baoshi/KiCad/(commit log)

2016-10-09 Ai-Thinker ESP-3212 has been replaced with ESP-32S. Add new ESP-32S library, footprint and 3D design. Do not use ESP-3212. It will be removed soon.
2016-10-09 Blue PCB on ESP-32S module
2019-12-28 Updated to KiCad 5 with FreeCad 3D projects
2020-03-02 Added ESP32-WROOM-32X modules. Added USB Type A connector (HRO_U-A-24DS-Y-1) Added LM320Y OLED panel
2020-03-07 Added some TI chips. Slight footprint naming unification.
2020-03-08 Added ADS1115. Modified some VSSPOP footprint.
2020-03-08 Add 2 pin connector. Add TVS diodes.
2020-03-08 Add some diodes and capacitor
2020-03-15 Added 3.5mm screw terminal
2020-03-17 Test Points, Tactile buttons
2020-03-20 Push button 6x6mm
2020-03-23 INA226 pin location change
2020-03-23 Samtec 2x05 50mil connector
2020-03-23 SOIC-8 EP footprint
2020-03-23 HRO right-angle USB connector
2020-03-25 Reference local 3D module for CP_6.3x5.8.kicad_mod
2020-03-30 Add mechanical slots
2020-03-30 Update I2C direction
2020-03-30 Add vendor name in sensors
2020-03-30 Footprint filter update
2020-04-02 Add PTH LED
2020-04-02 Mechanical holes
2020-04-02 Mechanical Hole
2021-03-06 Add XKB XFT-015-X SDCard socket
2021-03-08 Added Raspberry Pi
2021-03-17 Update RP2040 footprint
2021-03-28 Fix missing silkscreen on PJ-3270A-SMT
2021-03-28 Pin header rename
2021-04-03 Add 2pin connector with mount
2021-04-03 Added PCB Antenna
2021-04-03 Shorten Capacitor blade size
2021-04-03 Add PTS525S (copper head) switches
2021-05-04 Board-edge indication in Type C connector
2021-05-04 RP2040 silkscreen simplify
2021-05-05 Add 74LVC2G07 and footprint
2021-05-05 Update 50mil pin header
2021-05-05 Fix pin position
2021-05-06 Enlarge solder paste
2021-05-06 Add XSON-8, modify solder paste layer in *SONs
2021-05-12 Simplify silkscreen
2021-05-12 Add card detector for microsd socket
2021-05-12 Mounting change for iPhone8 speaker
2021-05-12 More connectors
2021-05-12 Add EP pin for PIC16F1503IMG
2021-06-01 Adjust RP2040 pin location
2021-06-04 Add more connectors
2021-06-07 Fix MCP73831 pin mode
2021-06-07 Add 2.54 vert pin header
2021-06-07 Add pinheader 2-pin
2021-06-07 Add molex 1.25mm pitch 2-pin connector
2021-06-08 Fix wrong pin number
2021-06-23 Silkscreen change for LEDs
2021-06-27 Enlarge solder pad
2021-07-03 Add 0.5mm testing pad
2021-07-04 Better diode fab image
2021-07-04 Better description for Alps buttons
2021-07-04 Add solder jumper
2021-12-25 Update for KiCad6
2022-01-09 Convert to KiCad6 modules format
2022-01-10 Add Hiros DF17(2.0)-20DP-0.5V(57)
2022-01-11 Add HIR_DF17(3.0)-20DS-0.5V(57)
2022-01-11 Add 14 pin connectors Add 20 pin double row connection with mounting point
2022-10-22 Add USBC connector Add Holtek USB controller
2022-10-31 Fix 0402 silkscreen
2023-03-26 Add ESP32-S3. Update readme.
2023-05-25 Sync folder names to KiCad7 style
2023-07-29 Add some TI regulators
2023-09-03 Update type-c connector
2023-09-16 Add some battery related symbol and footprint
2023-09-16 Use simple HRO-Type-C connector model
2023-09-16 Use simple 3d model for ESP32-S3
2026-03-12 Update for KiCad 9
    Add some footprints
